Andre-WL/Model_DC_Microgrid/A DC Housing Outreach proejct.pptx

## 2021/2022 FAN Summer Research Scholarship

Name: Andre Webber
Project: DC Housing Community Outreach Project

Notes: NAME:
Hello, my name is Andre. I am an Electrical and Electronics Engineering student at VUW.
PROJECT
Over the summer I have been working on a DC housing outreach project aimed at high school students.

## Project Details

- 4 scale model houses
- Simulation of household power consumption over a 24-hour period.
- Current Sampling

Notes: 4 scale model houses
The idea of this project is to produce 4 scale model houses, each containing “appliances” represented by LEDs and load resistors to dissipate power at a 1:100 scale to the appliances they represent.
Simulation of household power consumption over a 24-hour period.
Appliances must be individually switched to allow for a simulation of household power consumption over a 24-hour period.
Current Sampling
Current will be sampled at each simulation tick so a power vs time graph can be generated

## What I have done

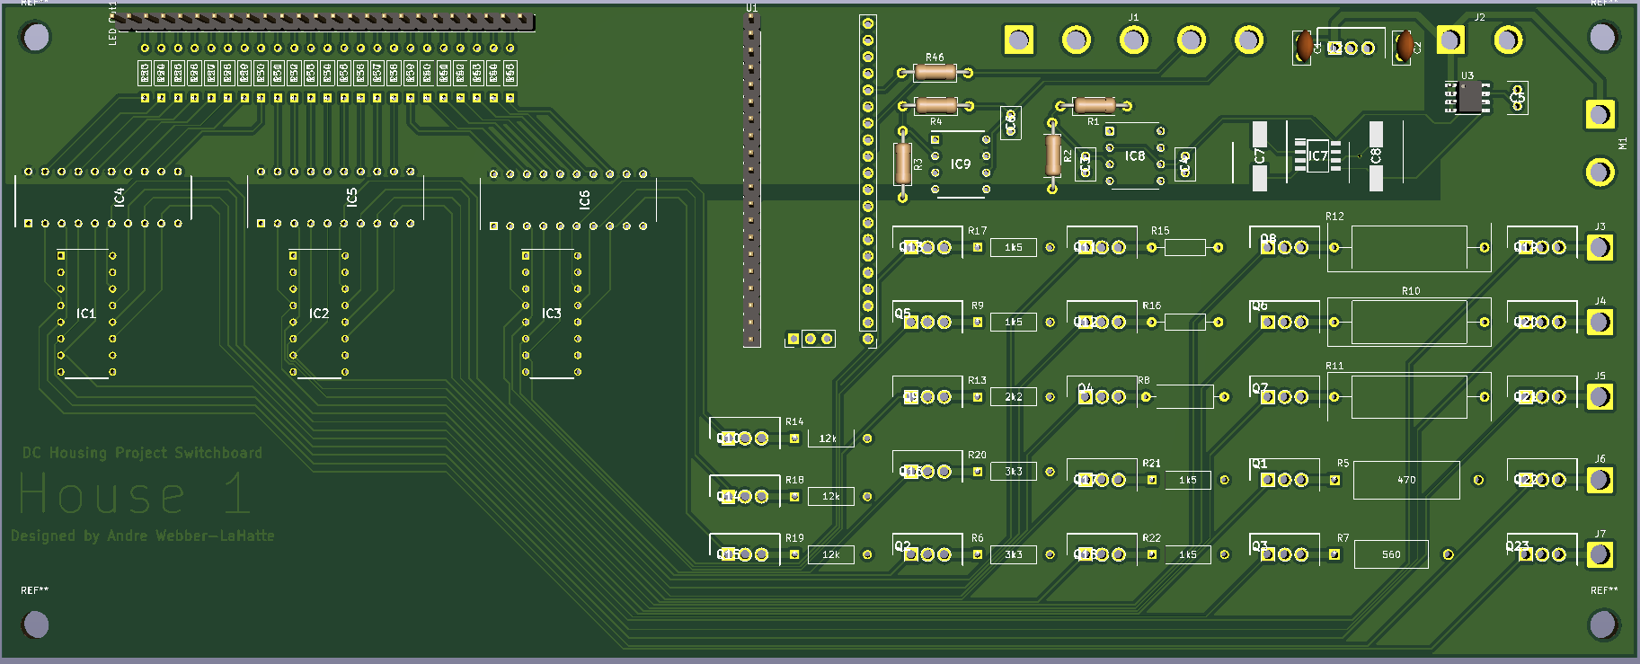
[picture p1: figure]

Switch Board

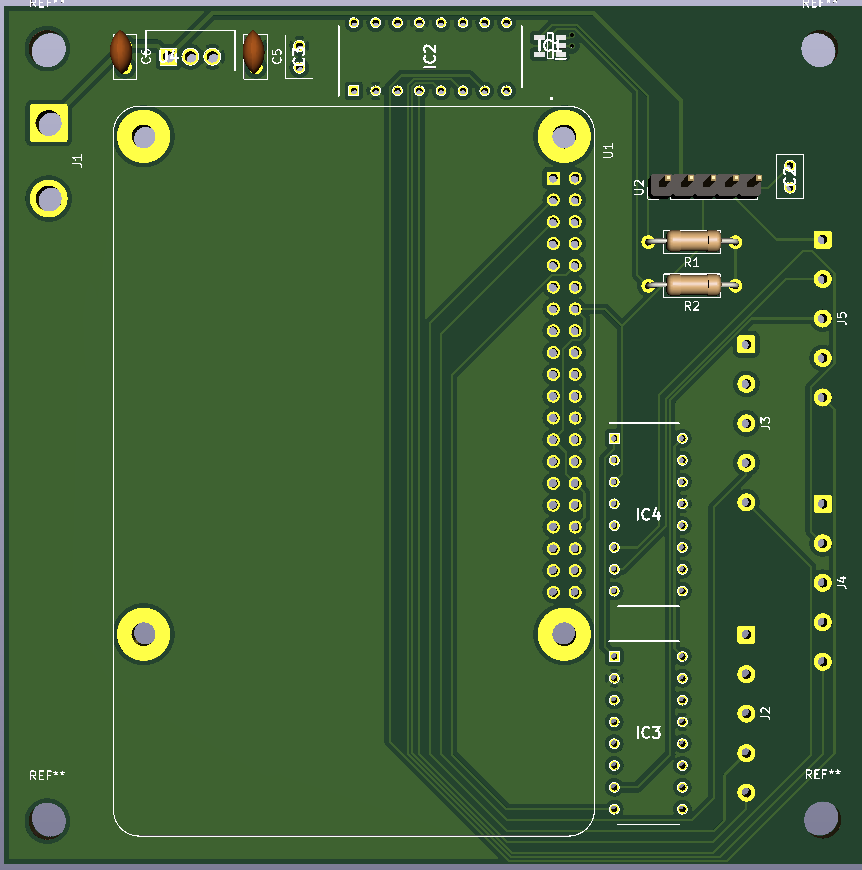
[picture p2: figure]

Control Board

Notes: So far, I have completed designs, and ordered components for 2 PCBs:
Switch Board
Using a Raspberry Pi Pico, this board controls the switching of each appliance, with an output that allows the LEDs within the house models to be connected. This board also houses the load resistors and current detection circuit for each house.
Control Board
Using a Raspberry Pi, this board can communicate and sample current individually from 4 houses

## Design Approach

- Communication
- Switching
- Current Detection

Notes: My design approach focussed on 3 main aspects.
Communication.
Communication.
Switching.
Switching.
Current Detection.
Current detection.

## Communication

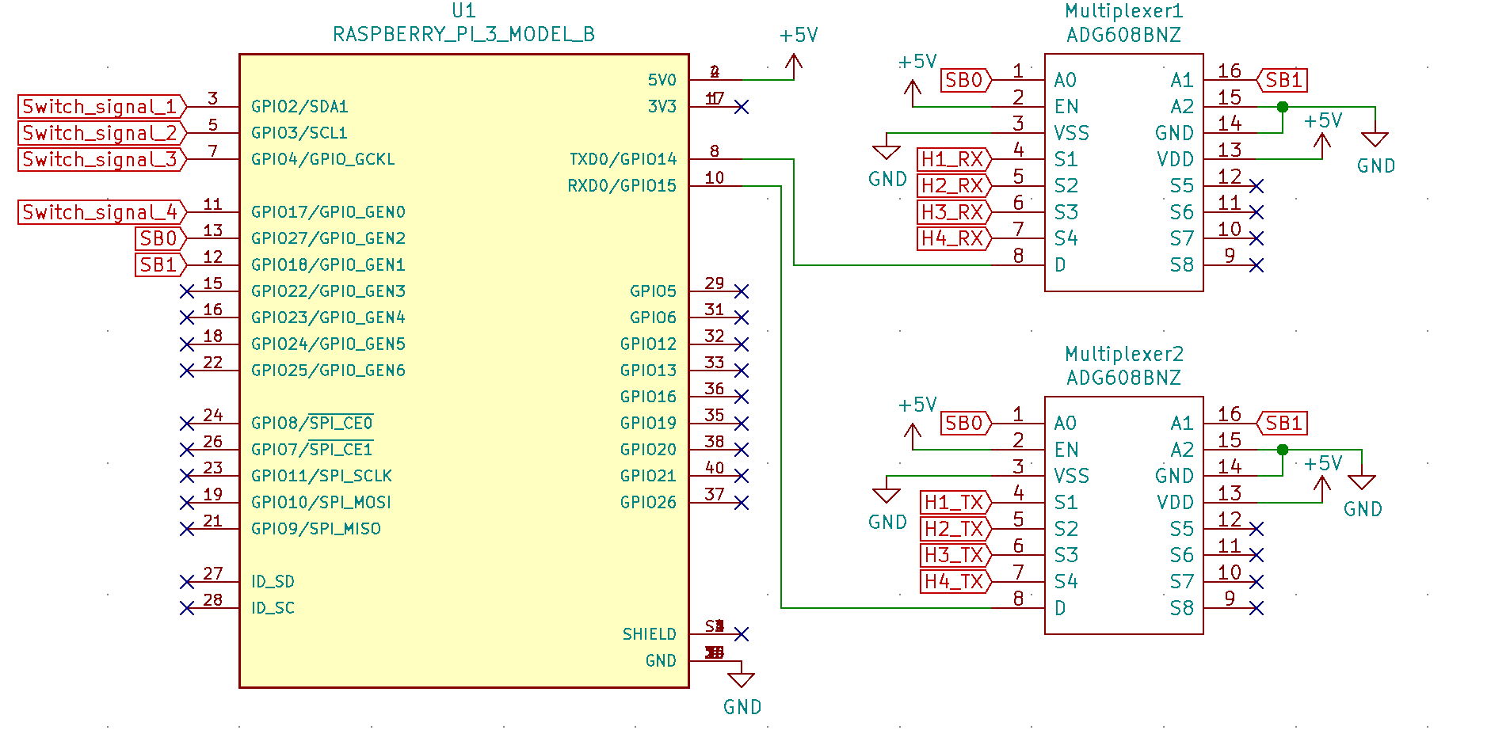
[picture p3: figure]

Control end

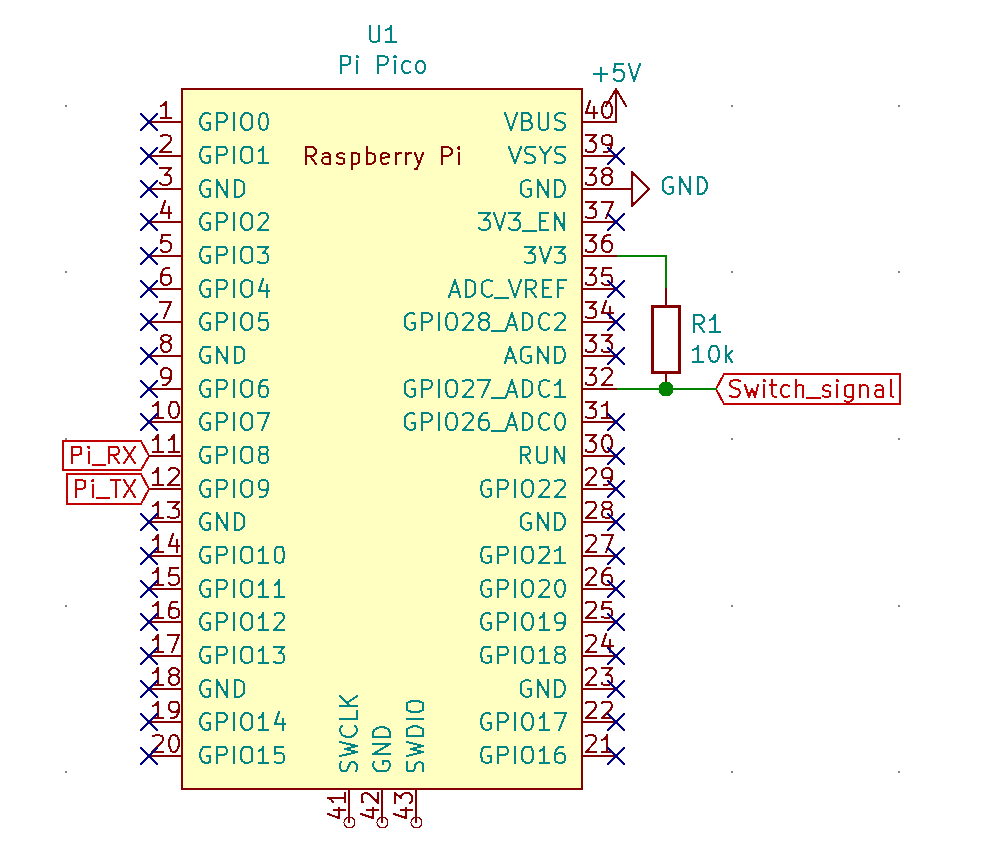
[picture p4: figure]

House end

Notes: Control end:
Using 2 4:1 multiplexers (or in this case, 2 8:1) the Raspberry Pi can communicate individually with each house over UART by selecting which house it is talking/listening to. The Pi also used a single line per house which will be pulled low to indicate a switch needs to be made.
House end:
This is a quick schematic showing the Pico end of communication topology. Showing the pull up resistor on the switch signal line.

## Switching

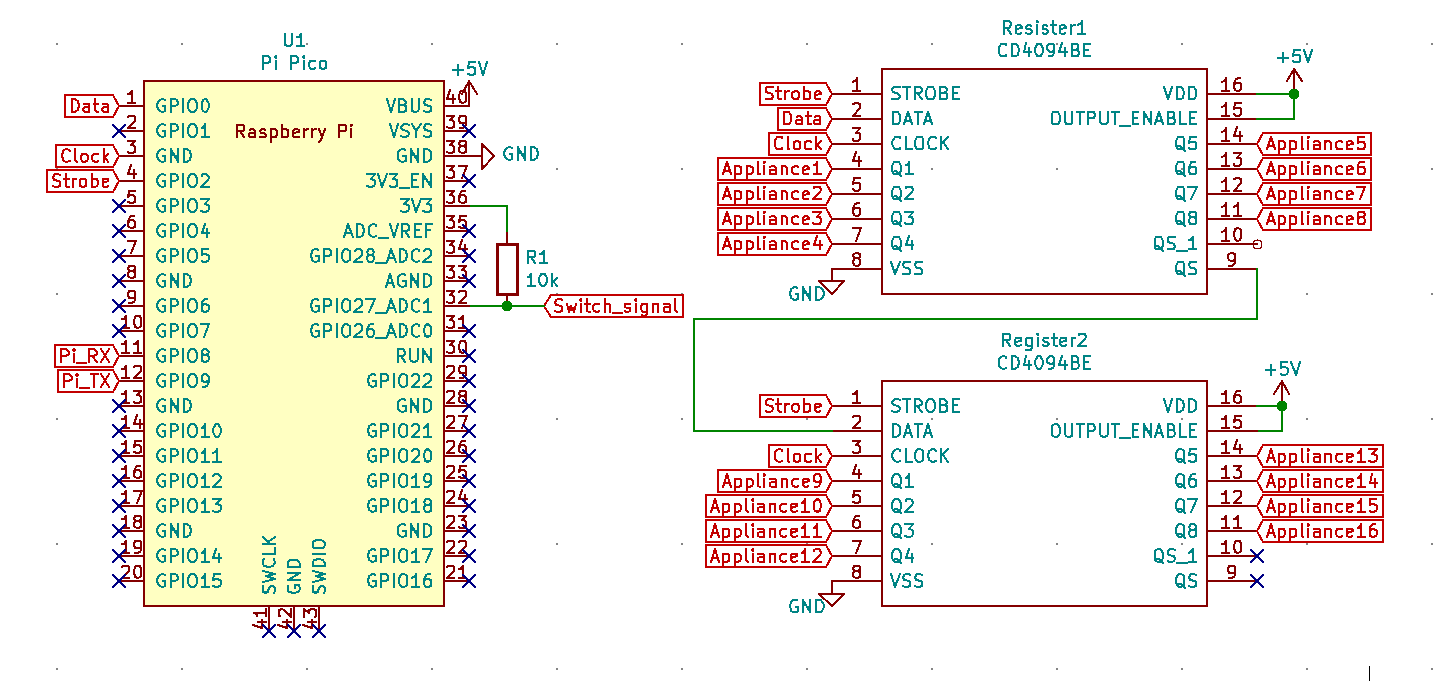
[picture p5: figure]

Shift Registers

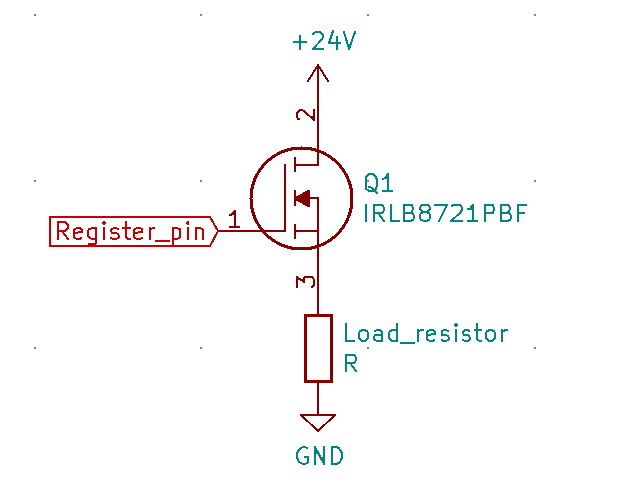
[picture p6: figure]

MOSFET

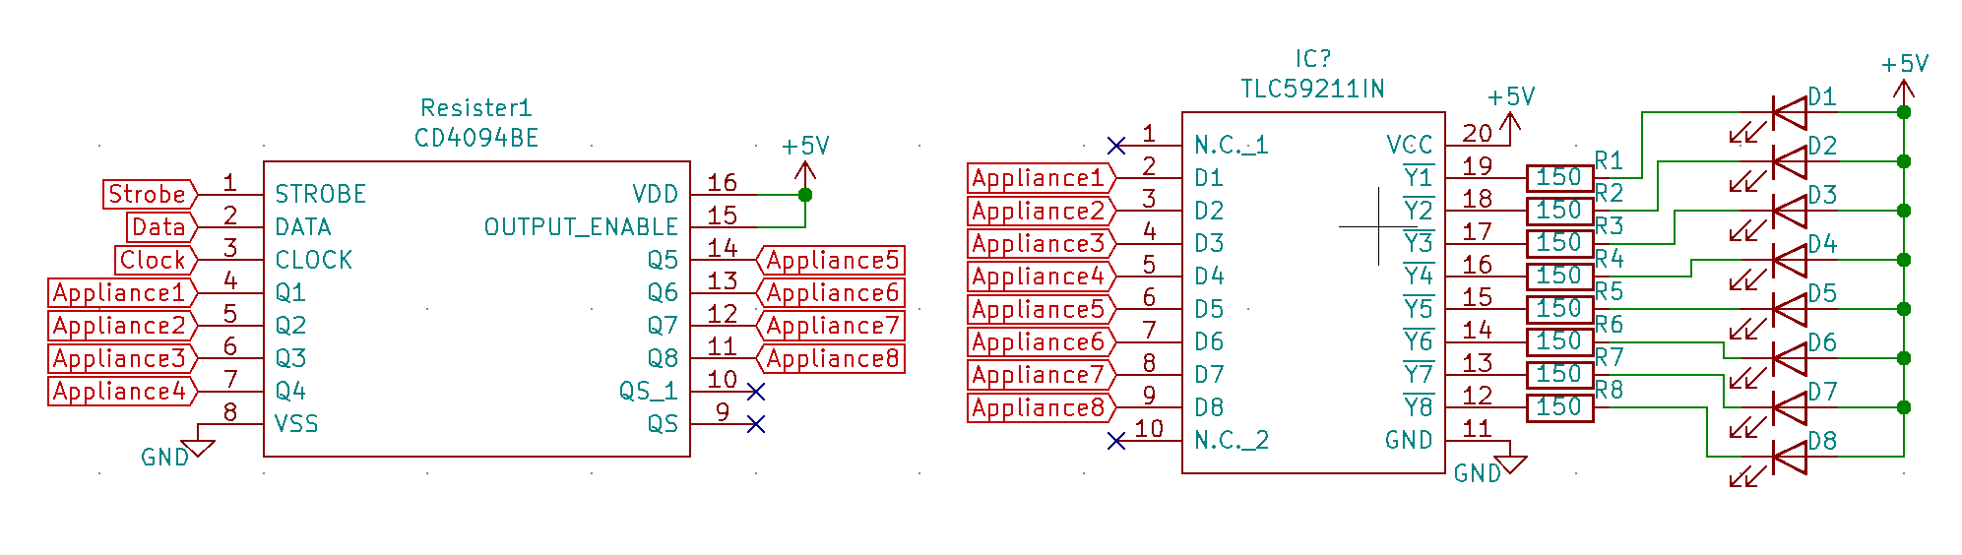
[picture p7: figure]

Sink Driver

Notes: Shift registers
The Pico switches appliances by loading values onto 8-bit shift register, using 1 register for each 8 appliances. They can be serially configured to behave as 16-bit, 24-bit, etc registers. The Pico can serially load values onto an internal register, before “strobing” to the output in parallel. This allows for values to be preloaded before a switch signal is received.
MOSFET
The registers output to MOSFETs to switch load resistors. I chose a MOSFET with a low R_(DS(on)) of 6.5mΩ , and a voltage rating greater than the 24V supply used for the load resistors.
Sink driver
As the registers cannot source enough current to drive LEDs, they also output to sink drivers. The schematic shows the connection made to LEDs, however in reality the LEDs will all be off board within a model house.
Shift registers
The Pico switches appliances by loading values onto 8-bit shift register, using 1 register for each 8 appliances. They can be serially configured to behave as 16-bit, 24-bit, etc registers. The Pico can serially load values onto an internal register, before “strobing” to the output in parallel. This allows for values to be preloaded before a switch signal is received.
MOSFET
The registers output to MOSFETs to switch load resistors. I chose a MOSFET with a low R_DS(on) of 6.5mΩ, and a voltage rating greater than the 24V supply used for the load resistors.
Sink driver
As the registers cannot source enough current to drive LEDs, they also output to sink drivers. The schematic shows the connection made to LEDs, however in reality the LEDs will all be off board within a model house.

## Current Detection

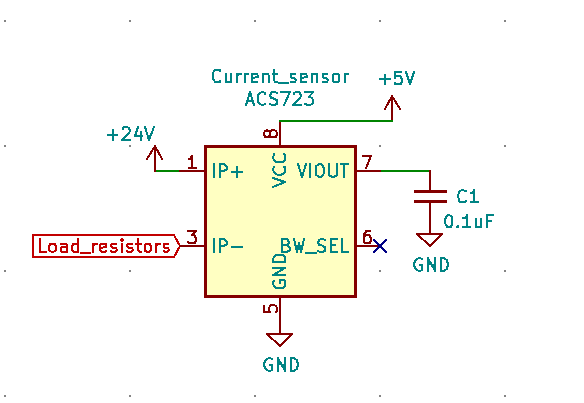
[picture p8: figure]

Sensor

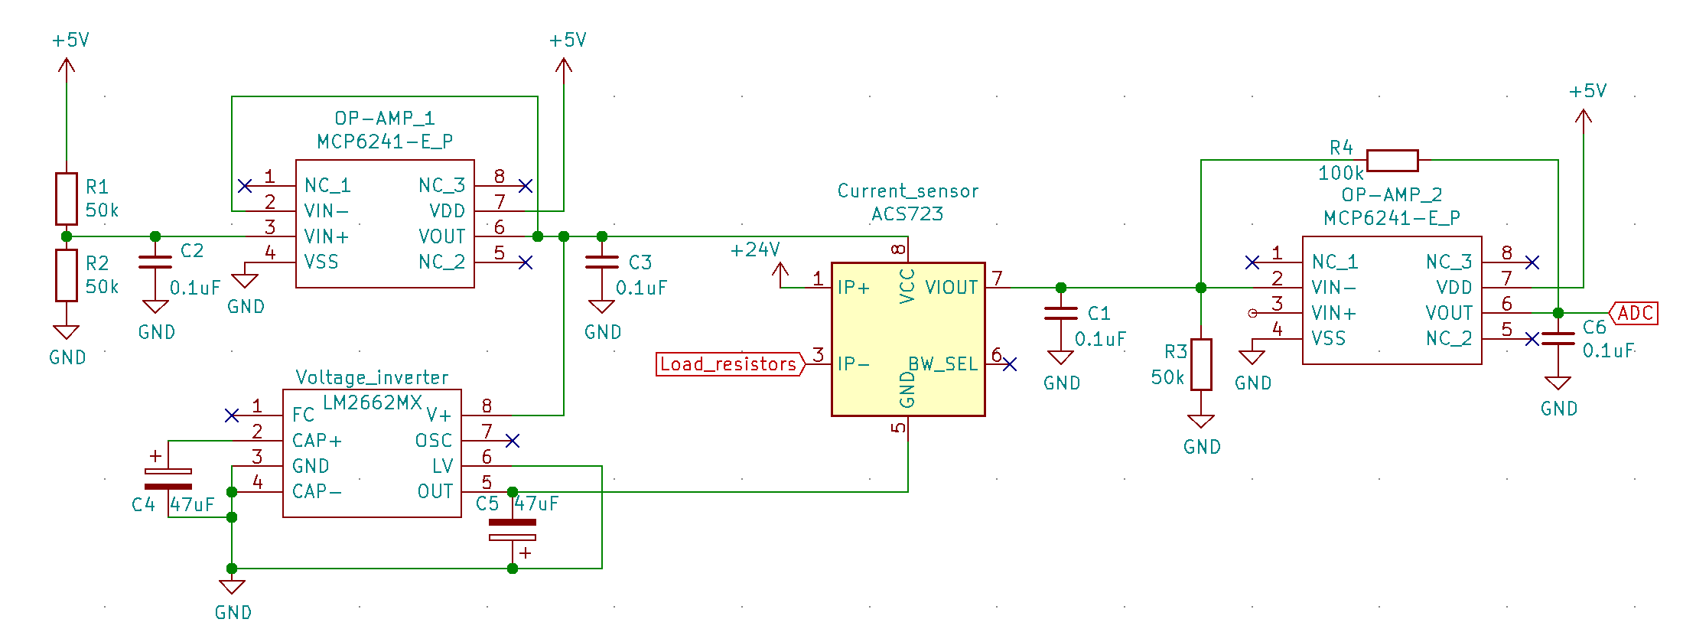
[picture p9: figure]

Inversion and Amplification

Notes: Sensor
The ACS721 is a bi direction current sensor that outputs 400mV/A
Testing
Testing one of these chips showed this output ratio to be accurate. Note the output of 2.5V at 0A due to being bidirectional.

## Current Detection

- Multiplexing
- ADC

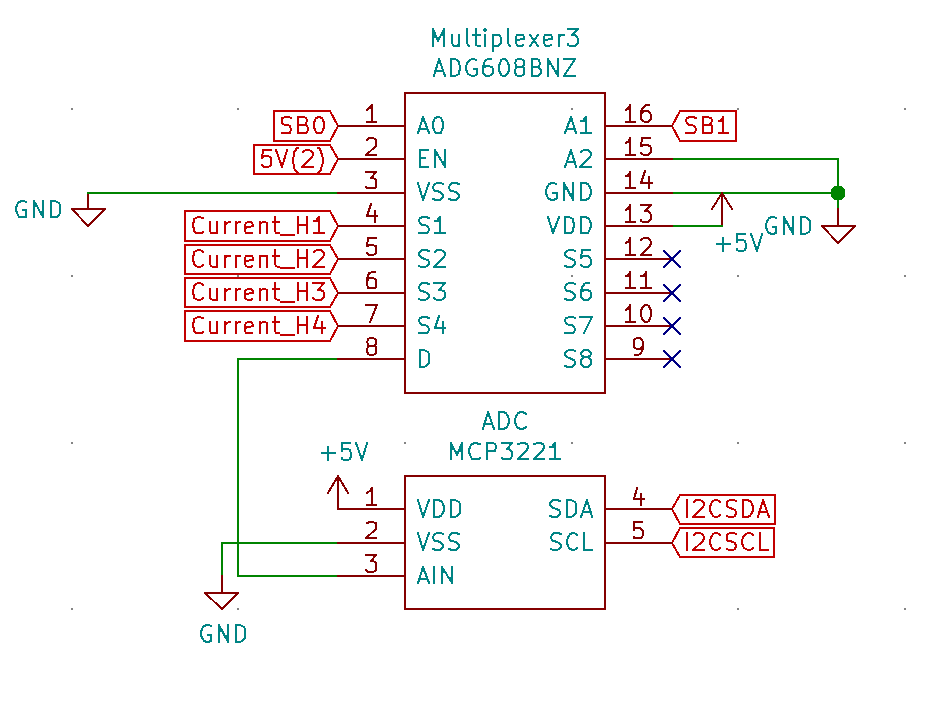
[picture p10: figure]

Notes: Multiplexing
The amplifier outputs to a multiplexer on the control board that then output to an ADC, this way current detection can be done across all 4 houses using a single ADC.
ADC
The MCP3221 ADC has 12-bit resolution, and a 22.3k sample rate.

## Switch Board Full Schematic

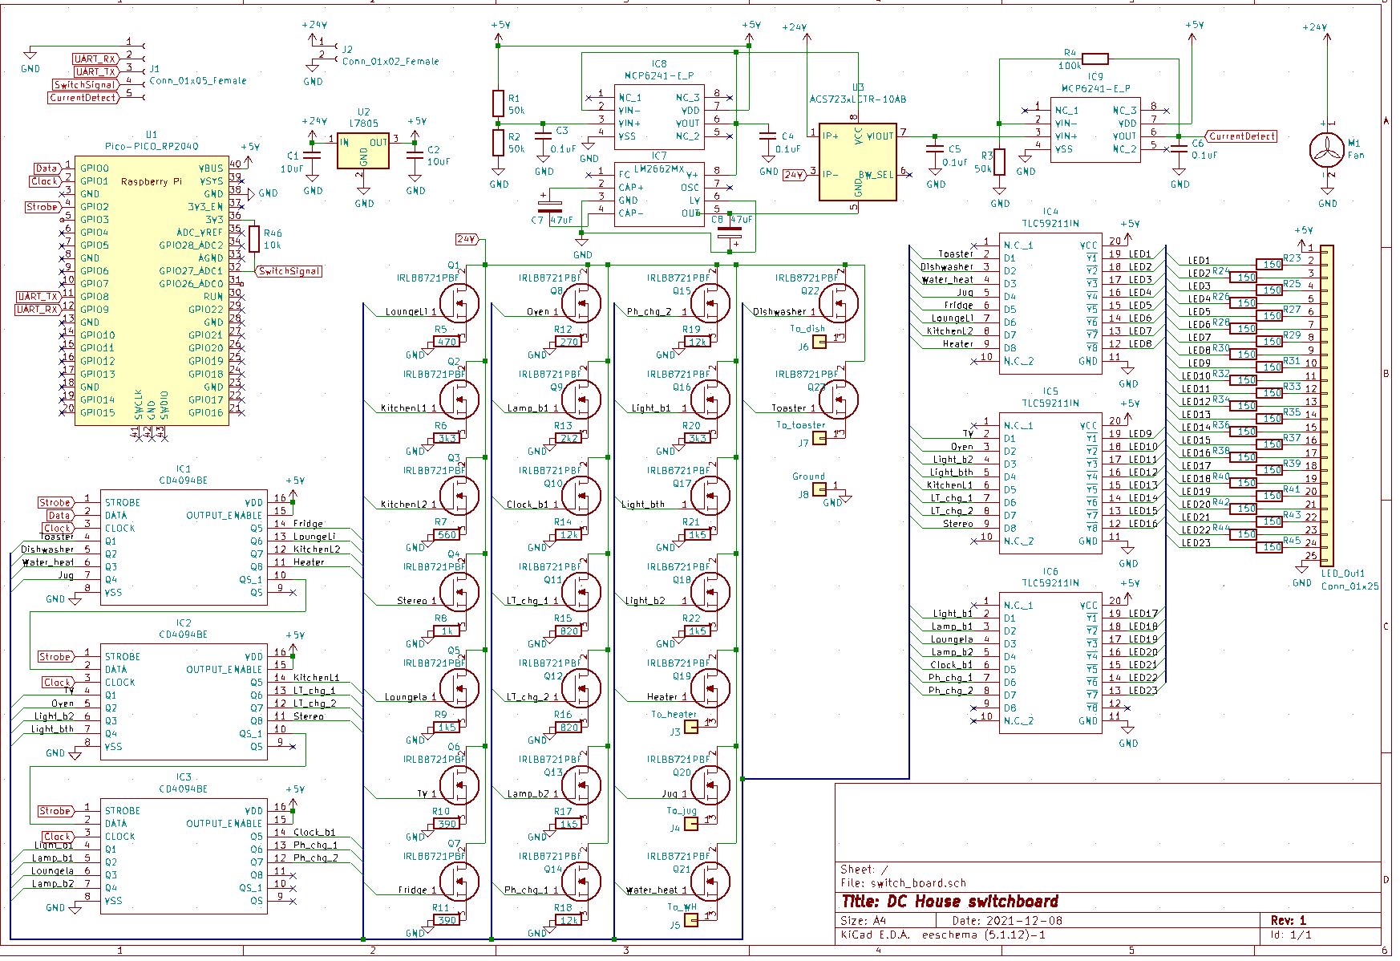
[picture p11: figure]

Notes: Say what it is

## Control Board Full Schematic

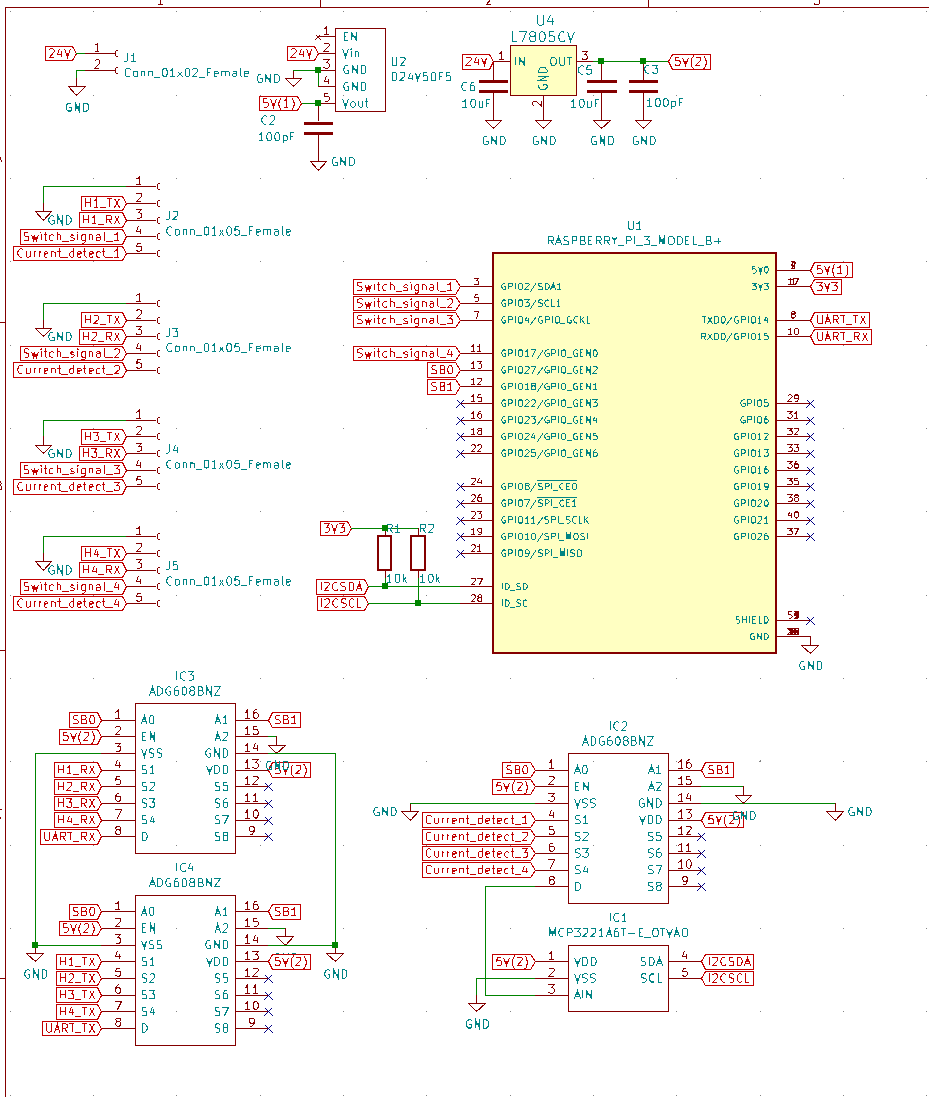
[picture p12: figure]

Notes: Say what it is

## Raspberry Pi Software Process

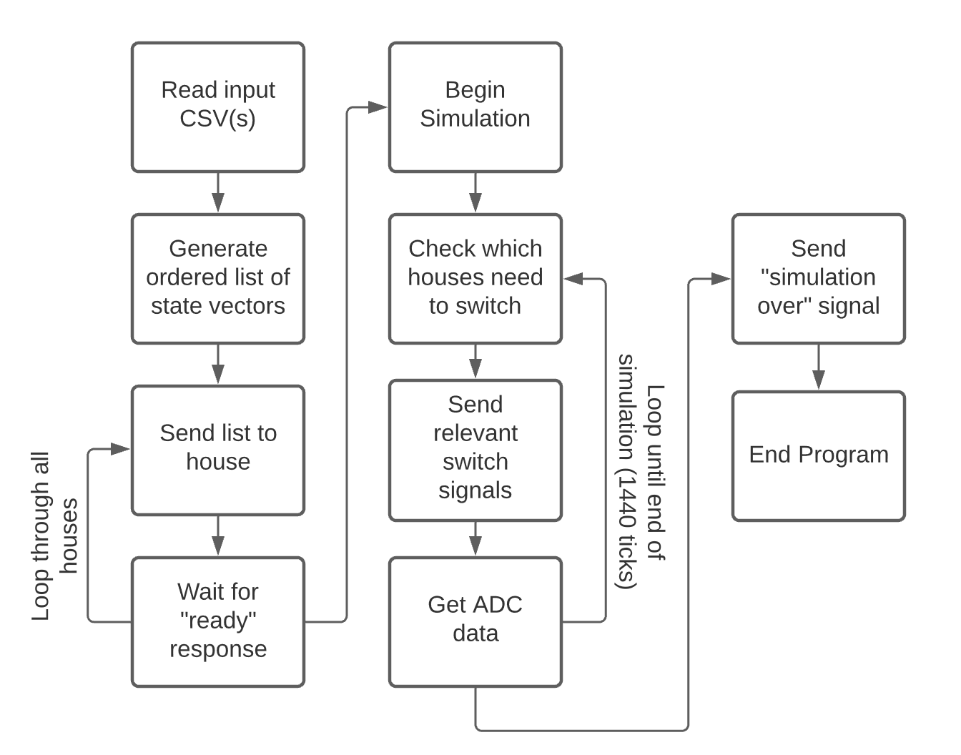
[picture p13: figure]

Notes: Quickly talk through process

## State Vectors

01101111

11101111

AND 01111111

OR 00000010

11101101

Notes: State vectors stored as 1 byte for each appliances
Made by performing logical operations on previous vector
*Click*
To switch this appliance
*Click*
Perform OR
*Click*
TO switch this one
*Click*
Perform AND
*Click*

## Pi Pico Software Process

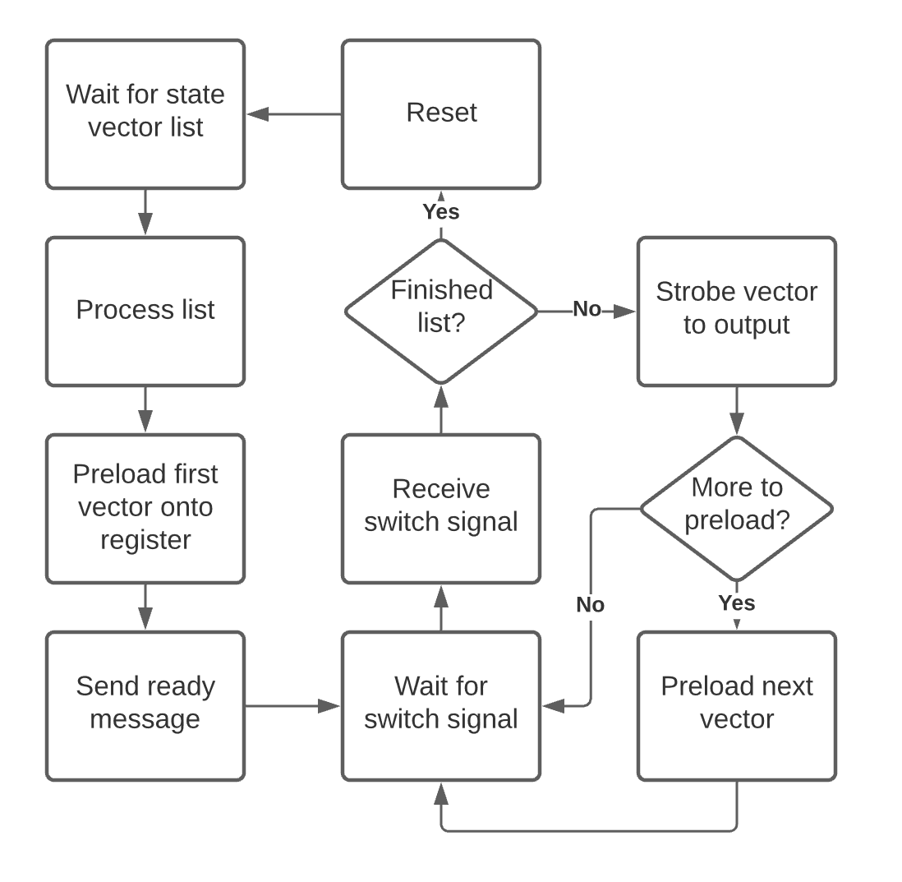
[picture p14: figure]

Notes: Quickly go over process

## What do I still need to do?

Finish Writing Software

01

Design Enclosures for PCBs

02

Make Switchboard PCBs for the other 3 houses

03

Populate PCBs

04

## What Have I Learnt?

- Read Thoroughly
- Component Selection

Notes: Read documentation thoroughly to understand details of what can and can’t be done, and what should be done.
Byte at a time communication
Decide what is needed, design circuit, and select components to make this, change circuit if necessary

## Questions?
