Andre-WL/Model_DC_Microgrid/Circuit_Boards/C320C104J3G5TA/3D/C320C104J3G5TA.stp

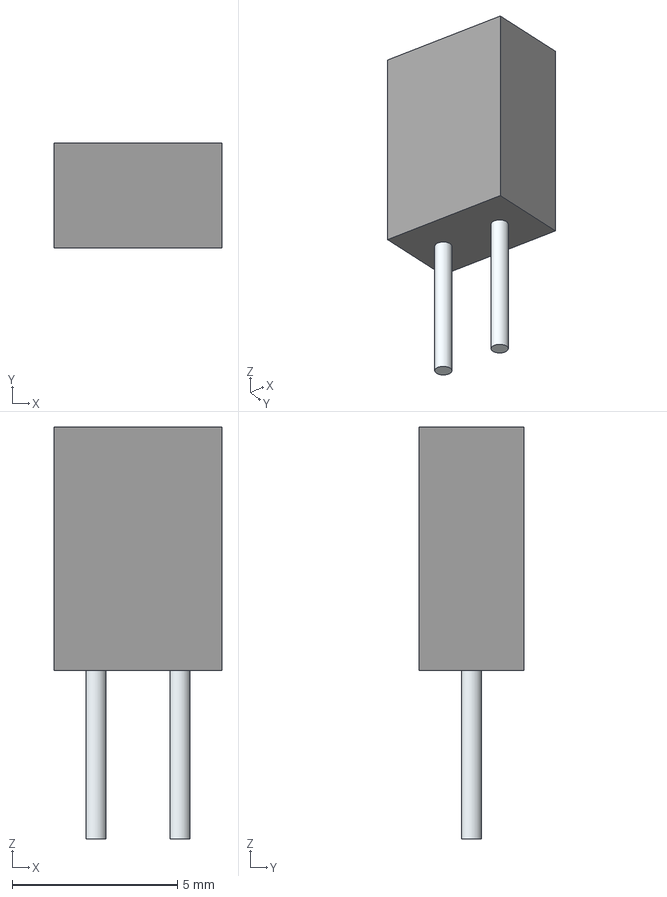
[picture p27: CAD file, 2022-10-04]
Circuit_Boards/C320C104J3G5TA/3D/C320C104J3G5TA.stp
5.08 x 3.18 x 12.5 mm
Leads x 2
