Andre-WL/Model_DC_Microgrid/Circuit_Boards/house_control/ADG608BNZ/3D/ADG608BNZ.stp

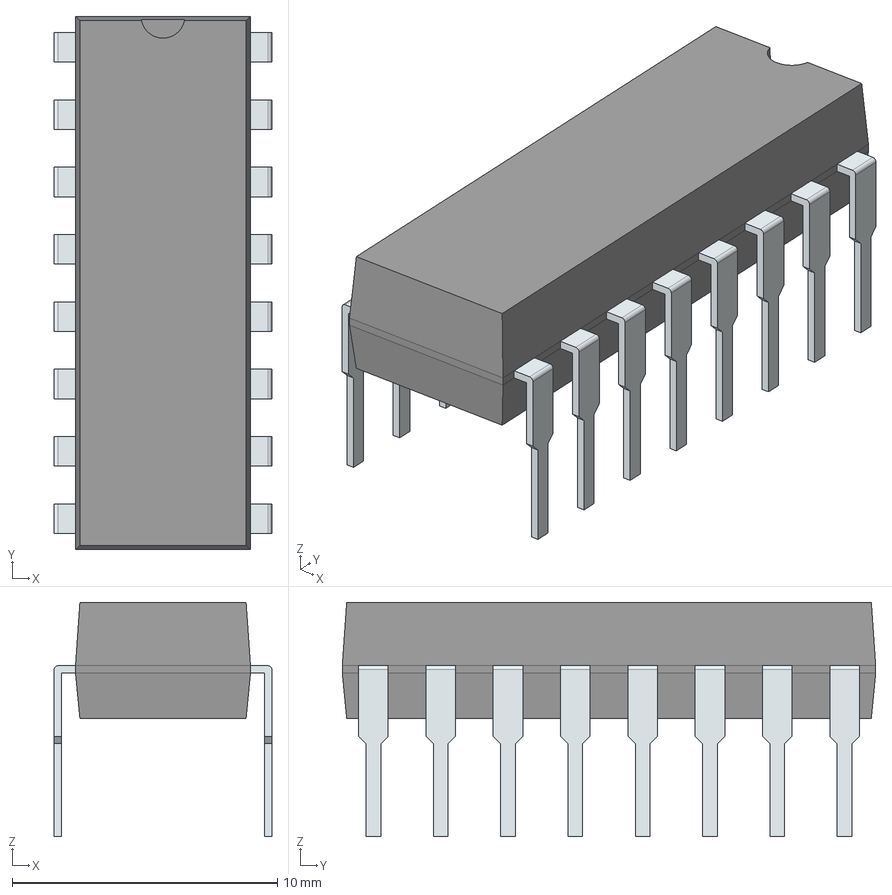
[picture p28: CAD file, 2022-10-04]
Circuit_Boards/house_control/ADG608BNZ/3D/ADG608BNZ.stp
8.21 x 20.1 x 8.83 mm
PinsArrayLR
