Andre-WL/Model_DC_Microgrid/(list of files, cad)

Other CAD files:
Circuit_Boards/C320C104J3G5TA/3D/C320C104J3G5TA.stl
Circuit_Boards/C320C104J3G5TA/Allegro/c320c104j3g5ta.psm
Circuit_Boards/C320C104J3G5TA/DEHDL/c320c104j3g5ta/chips/chips.prt
Circuit_Boards/house_control/ADG608BNZ/3D/ADG608BNZ.stl
Circuit_Boards/house_control/ADG608BNZ/Allegro/dip794w56p254l2013h533q16n.psm
Circuit_Boards/house_control/ADG608BNZ/DEHDL/adg608bnz/chips/chips.prt
