Andre-WL/Model_DC_Microgrid/Circuit_Boards/switch_board_house2/switch_board_house2.kicad_pcb

## KiCad design Circuit_Boards/switch_board_house2/switch_board_house2.kicad_pcb (2022-10-04)

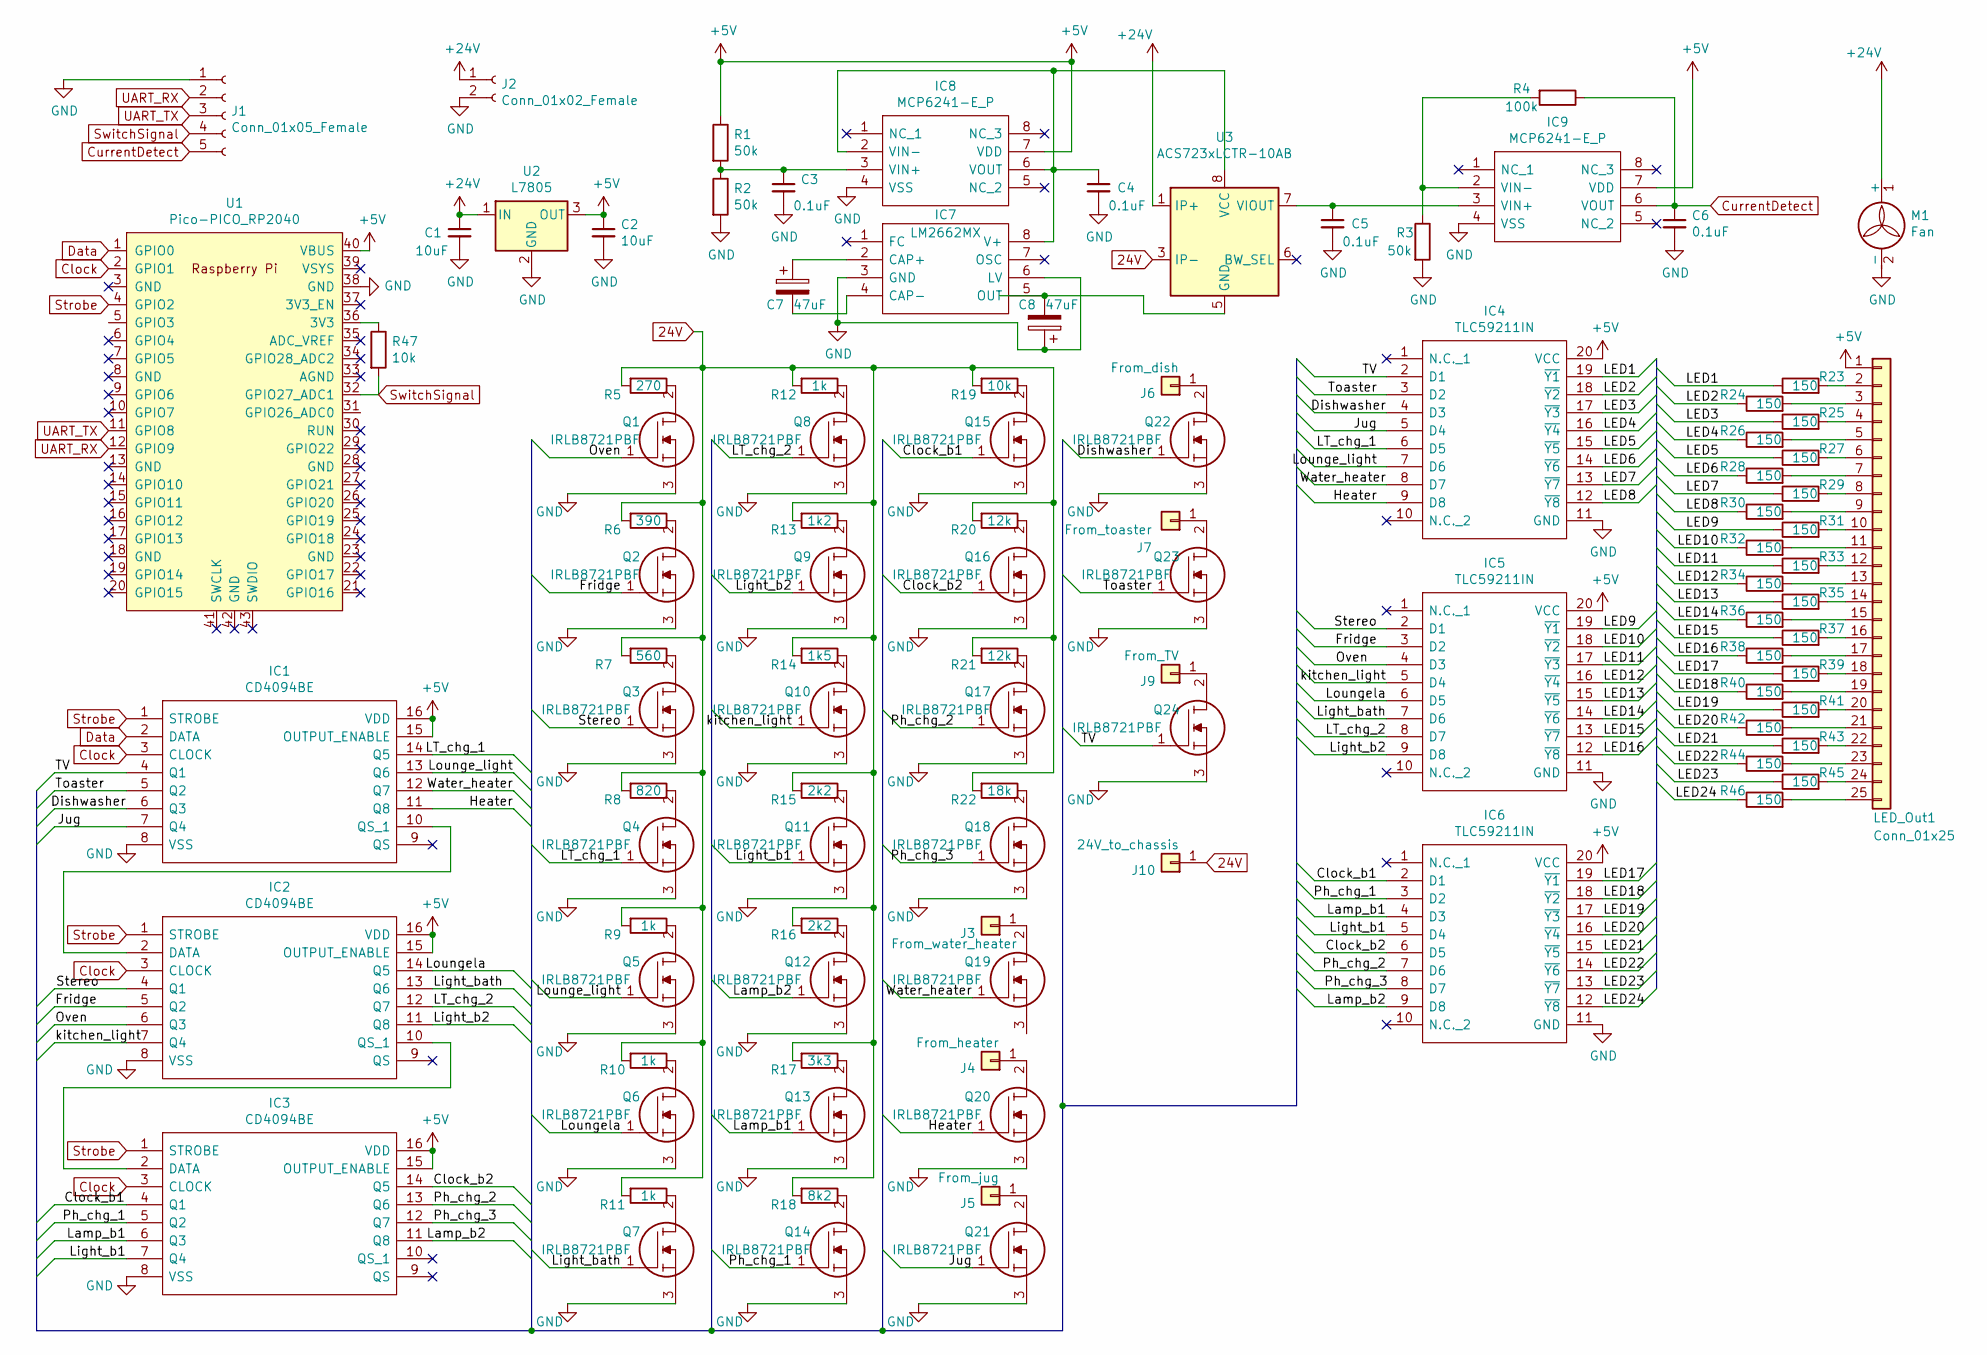
[picture p31: schematic switch_board_house2.sch, DC House switchboard]

Parts:
C1, C2: 10uF; C_Disc_D5.0mm_W2.5mm_P2.50mm
C3, C4, C5, C6: 0.1uF; C320C104J3G5TA
C7, C8: 47uF; CAPAE825X1030N
IC1, IC2, IC3: CD4094BE; DIP794W53P254L1930H508Q16N; Manufacturer_Part_Number CD4094BE; Mouser Part Number 595-CD4094BE
IC4, IC5, IC6: TLC59211IN; DIP794W53P254L2540H508Q20N; Manufacturer_Part_Number TLC59211IN; Mouser Part Number 595-TLC59211IN
IC7: LM2662MX; SOIC127P600X175-8N; Manufacturer_Part_Number LM2662MX; Mouser Part Number 926-LM2662MX
IC8, IC9: MCP6241-E_P; DIP781W56P254L950H533Q8N; Manufacturer_Part_Number MCP6241-E/P; Mouser Part Number 579-MCP6241-E/P
J1: Conn_01x05_Female; SolderWire-2.5sqmm_1x05_P8.8mm_D2.4mm_OD4.4mm
J2: Conn_01x02_Female; SolderWire-2.5sqmm_1x02_P8.8mm_D2.4mm_OD4.4mm
J3: From_water_heater; SolderWire-2.5sqmm_1x01_D2.4mm_OD3.6mm
J4: From_heater; SolderWire-2.5sqmm_1x01_D2.4mm_OD3.6mm
J5: From_jug; SolderWire-2.5sqmm_1x01_D2.4mm_OD3.6mm
J6: From_dish; SolderWire-2.5sqmm_1x01_D2.4mm_OD3.6mm
J7: From_toaster; SolderWire-2.5sqmm_1x01_D2.4mm_OD3.6mm
J9: From_TV; SolderWire-2.5sqmm_1x01_D2.4mm_OD3.6mm
J10: 24V_to_chassis; SolderWire-2.5sqmm_1x01_D2.4mm_OD3.6mm
LED_Out1: Conn_01x25; PinHeader_1x25_P2.54mm_Vertical
M1: Fan; SolderWire-2.5sqmm_1x02_P8.8mm_D2.4mm_OD4.4mm
Q1, Q2, Q3, Q4, Q5, Q6, Q7, Q8, Q9, Q10, Q11, Q12, Q13, Q14, Q15, Q16, Q17, Q18, Q19, Q20, Q21, Q22, Q23, Q24: IRLB8721PBF; TO254P483X1016X1994-3P; Manufacturer_Part_Number IRLB8721PBF; Mouser Part Number 942-IRLB8721PBF
R1, R2, R3: 50k; R_Axial_DIN0207_L6.3mm_D2.5mm_P10.16mm_Horizontal
R4: 100k; R_Axial_DIN0207_L6.3mm_D2.5mm_P10.16mm_Horizontal
R5: 270; ROX5SS
R6: 390; ROX5SS
R7: 560; ROX2SJ560R
R8: 820; MFP1_res
R9, R10, R11, R12: 1k; 1K_load
R13: 1k2; 1k2_res_v2
R14: 1k5; LR1F1K5
R15, R16: 2k2; LR1F1K5
R17: 3k3; LR1F3K3
R18: 8k2; LR1F1K5
R19: 10k; 10k_res
R20, R21: 12k; LR1F1K5
R22: 18k; 18k_res
R23, R24, R25, R26, R27, R28, R29, R30, R31, R32, R33, R34, R35, R36, R37, R38, R39, R40, R41, R42, R43, R44, R45, R46: 150; RNMF14FTC150R
R47: 10k; R_Axial_DIN0207_L6.3mm_D2.5mm_P10.16mm_Horizontal
U1: Pico-PICO_RP2040; PinHeader_2x20_P2.54mm_PICO
U2: L7805; TO255P460X1020X2008-3P
U3: ACS723xLCTR-10AB; SOIC-8_3.9x4.9mm_P1.27mm

Connections:
24V: J10.1, R5.2, R6.2, R7.2, R8.2, R9.2, R10.2, R11.2, R12.2, R13.2, R14.2, R15.2, R16.2, R17.2, R18.2, R19.2, R20.2, R21.2, R22.2, U3.3 (IP-), U3.4 (IP-)
+5V: C2.1, IC1.15 (OUTPUT_ENABLE), IC1.16 (VDD), IC2.15 (OUTPUT_ENABLE), IC2.16 (VDD), IC3.15 (OUTPUT_ENABLE), IC3.16 (VDD), IC4.20 (VCC), IC5.20 (VCC), IC6.20 (VCC), IC8.7 (VDD), IC9.7 (VDD), LED_Out1.1, R1.1, U1.40 (VBUS), U2.3 (OUT)
+24V: C1.1, J2.1, M1.1 (+), U2.1 (IN), U3.1 (IP+), U3.2 (IP+)
/Clock_b1: IC3.4 (Q1), IC6.2 (D1), Q15.1
/Clock_b2: IC3.14 (Q5), IC6.6 (D5), Q16.1
/Dishwasher: IC1.6 (Q3), IC4.4 (D3), Q22.1
/Fridge: IC2.5 (Q2), IC5.3 (D2), Q2.1
/Heater: IC1.11 (Q8), IC4.9 (D8), Q20.1
/Jug: IC1.7 (Q4), IC4.5 (D4), Q21.1
/LED1: IC4.19 (~Y1), R23.1
/LED2: IC4.18 (~Y2), R24.1
/LED3: IC4.17 (~Y3), R25.1
/LED4: IC4.16 (~Y4), R26.1
/LED5: IC4.15 (~Y5), R27.1
/LED6: IC4.14 (~Y6), R28.1
/LED7: IC4.13 (~Y7), R29.1
/LED8: IC4.12 (~Y8), R30.1
/LED9: IC5.19 (~Y1), R31.1
/LED10: IC5.18 (~Y2), R32.1
/LED11: IC5.17 (~Y3), R33.1
/LED12: IC5.16 (~Y4), R34.1
/LED13: IC5.15 (~Y5), R35.1
/LED14: IC5.14 (~Y6), R36.1
/LED15: IC5.13 (~Y7), R37.1
/LED16: IC5.12 (~Y8), R38.1
/LED17: IC6.19 (~Y1), R39.1
/LED18: IC6.18 (~Y2), R40.1
/LED19: IC6.17 (~Y3), R41.1
/LED20: IC6.16 (~Y4), R42.1
/LED21: IC6.15 (~Y5), R43.1
/LED22: IC6.14 (~Y6), R44.1
/LED23: IC6.13 (~Y7), R45.1
/LED24: IC6.12 (~Y8), R46.1
/LT_chg_1: IC1.14 (Q5), IC4.6 (D5), Q4.1
/LT_chg_2: IC2.12 (Q7), IC5.8 (D7), Q8.1
/Lamp_b1: IC3.6 (Q3), IC6.4 (D3), Q13.1
/Lamp_b2: IC3.11 (Q8), IC6.9 (D8), Q12.1
/Light_b1: IC3.7 (Q4), IC6.5 (D4), Q11.1
/Light_b2: IC2.11 (Q8), IC5.9 (D8), Q9.1
/Light_bath: IC2.13 (Q6), IC5.7 (D6), Q7.1
/Lounge_light: IC1.13 (Q6), IC4.7 (D6), Q5.1
/Loungela: IC2.14 (Q5), IC5.6 (D5), Q6.1
/Oven: IC2.6 (Q3), IC5.4 (D3), Q1.1
/Ph_chg_1: IC3.5 (Q2), IC6.3 (D2), Q14.1
/Ph_chg_2: IC3.13 (Q6), IC6.7 (D6), Q17.1
/Ph_chg_3: IC3.12 (Q7), IC6.8 (D7), Q18.1
/Stereo: IC2.4 (Q1), IC5.2 (D1), Q3.1
/TV: IC1.4 (Q1), IC4.2 (D1), Q24.1
/Toaster: IC1.5 (Q2), IC4.3 (D2), Q23.1
/Water_heater: IC1.12 (Q7), IC4.8 (D7), Q19.1
/kitchen_light: IC2.7 (Q4), IC5.5 (D4), Q10.1
Clock: IC1.3 (CLOCK), IC2.3 (CLOCK), IC3.3 (CLOCK), U1.2 (GPIO1)
CurrentDetect: C6.1, IC9.6 (VOUT), J1.5, R4.1
Data: IC1.2 (DATA), U1.1 (GPIO0)
GND: C1.2, C2.2, C3.2, C4.2, C5.2, C6.2, C8.1, IC1.8 (VSS), IC2.8 (VSS), IC3.8 (VSS), IC4.11 (GND), IC5.11 (GND), IC6.11 (GND), IC7.3 (GND), IC7.6 (LV), IC8.4 (VSS), IC9.4 (VSS), J1.1, J2.2, M1.2 (-), Q1.3, Q2.3, Q3.3, Q4.3, Q5.3, Q6.3, Q7.3, Q8.3, Q9.3, Q10.3, Q11.3, Q12.3, Q13.3, Q14.3, Q15.3, Q16.3, Q17.3, Q18.3, Q20.3, Q21.3, Q22.3, Q23.3, Q24.3, R2.2, R3.2, U1.38 (GND), U2.2 (GND)
unnamed: C3.1, IC8.3 (VIN+), R1.2, R2.1
unnamed: C4.1, IC7.8 (V+), IC8.2 (VIN-), IC8.6 (VOUT), U3.8 (VCC)
unnamed: C5.1, IC9.3 (VIN+), U3.7 (VIOUT)
unnamed: C7.1, IC7.2 (CAP+)
unnamed: C7.2, IC7.4 (CAP-)
unnamed: C8.2, IC7.5 (OUT), U3.5 (GND)
unnamed: IC1.10 (QS_1), IC2.2 (DATA)
unnamed: IC2.10 (QS_1), IC3.2 (DATA)
unnamed: IC9.2 (VIN-), R3.1, R4.2
unnamed: J3.1, Q19.2
unnamed: J4.1, Q20.2
unnamed: J5.1, Q21.2
unnamed: J6.1, Q22.2
unnamed: J7.1, Q23.2
unnamed: J9.1, Q24.2
unnamed: LED_Out1.2, R23.2
unnamed: LED_Out1.3, R24.2
unnamed: LED_Out1.4, R25.2
unnamed: LED_Out1.5, R26.2
unnamed: LED_Out1.6, R27.2
unnamed: LED_Out1.7, R28.2
unnamed: LED_Out1.8, R29.2
unnamed: LED_Out1.9, R30.2
unnamed: LED_Out1.10, R31.2
unnamed: LED_Out1.11, R32.2
unnamed: LED_Out1.12, R33.2
unnamed: LED_Out1.13, R34.2
unnamed: LED_Out1.14, R35.2
unnamed: LED_Out1.15, R36.2
unnamed: LED_Out1.16, R37.2
unnamed: LED_Out1.17, R38.2
unnamed: LED_Out1.18, R39.2
unnamed: LED_Out1.19, R40.2
unnamed: LED_Out1.20, R41.2
unnamed: LED_Out1.21, R42.2
unnamed: LED_Out1.22, R43.2
unnamed: LED_Out1.23, R44.2
unnamed: LED_Out1.24, R45.2
unnamed: LED_Out1.25, R46.2
unnamed: Q1.2, R5.1
unnamed: Q2.2, R6.1
unnamed: Q3.2, R7.1
unnamed: Q4.2, R8.1
unnamed: Q5.2, R9.1
unnamed: Q6.2, R10.1
unnamed: Q7.2, R11.1
unnamed: Q8.2, R12.1
unnamed: Q9.2, R13.1
unnamed: Q10.2, R14.1
unnamed: Q11.2, R15.1
unnamed: Q12.2, R16.1
unnamed: Q13.2, R17.1
unnamed: Q14.2, R18.1
unnamed: Q15.2, R19.1
unnamed: Q16.2, R20.1
unnamed: Q17.2, R21.1
unnamed: Q18.2, R22.1
unnamed: R47.1, U1.36 (3V3)
Strobe: IC1.1 (STROBE), IC2.1 (STROBE), IC3.1 (STROBE), U1.4 (GPIO2)
SwitchSignal: J1.4, R47.2, U1.32 (GPIO27_ADC1)
UART_RX: J1.2, U1.12 (GPIO9)
UART_TX: J1.3, U1.11 (GPIO8)

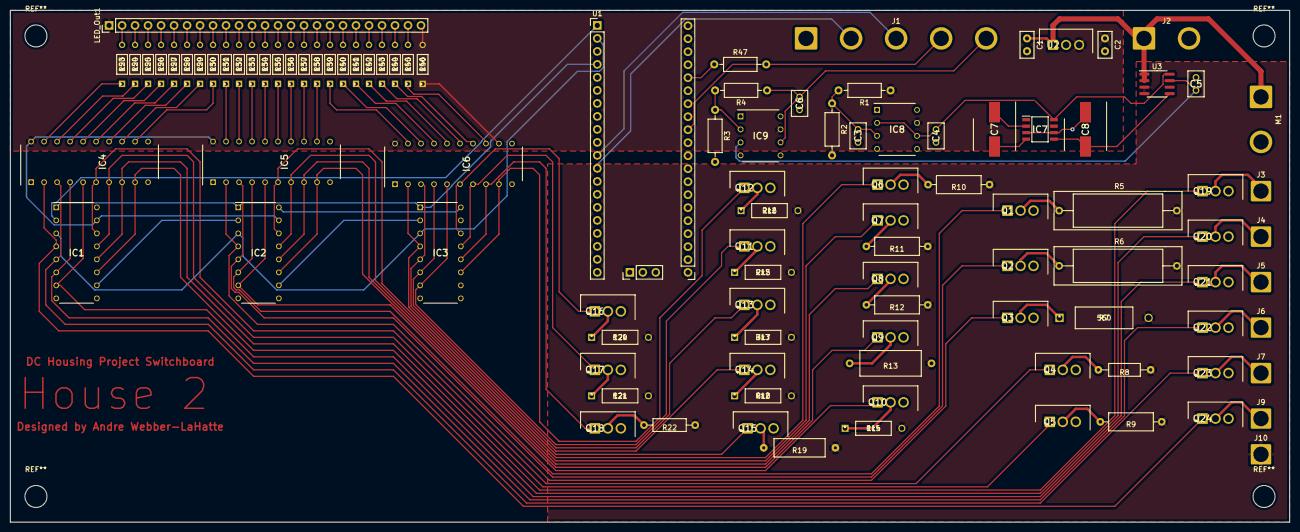
[picture p32: board switch_board_house2.kicad_pcb from above]

Board: 2 copper layers, 250.0 x 100.0 mm, 102 parts (0 on the bottom side), 117 nets.
