Andre-WL/Model_DC_Microgrid/Circuit_Boards/house_control/HouseController.kicad_pcb

## KiCad design Circuit_Boards/house_control/HouseController.kicad_pcb (2022-10-04)

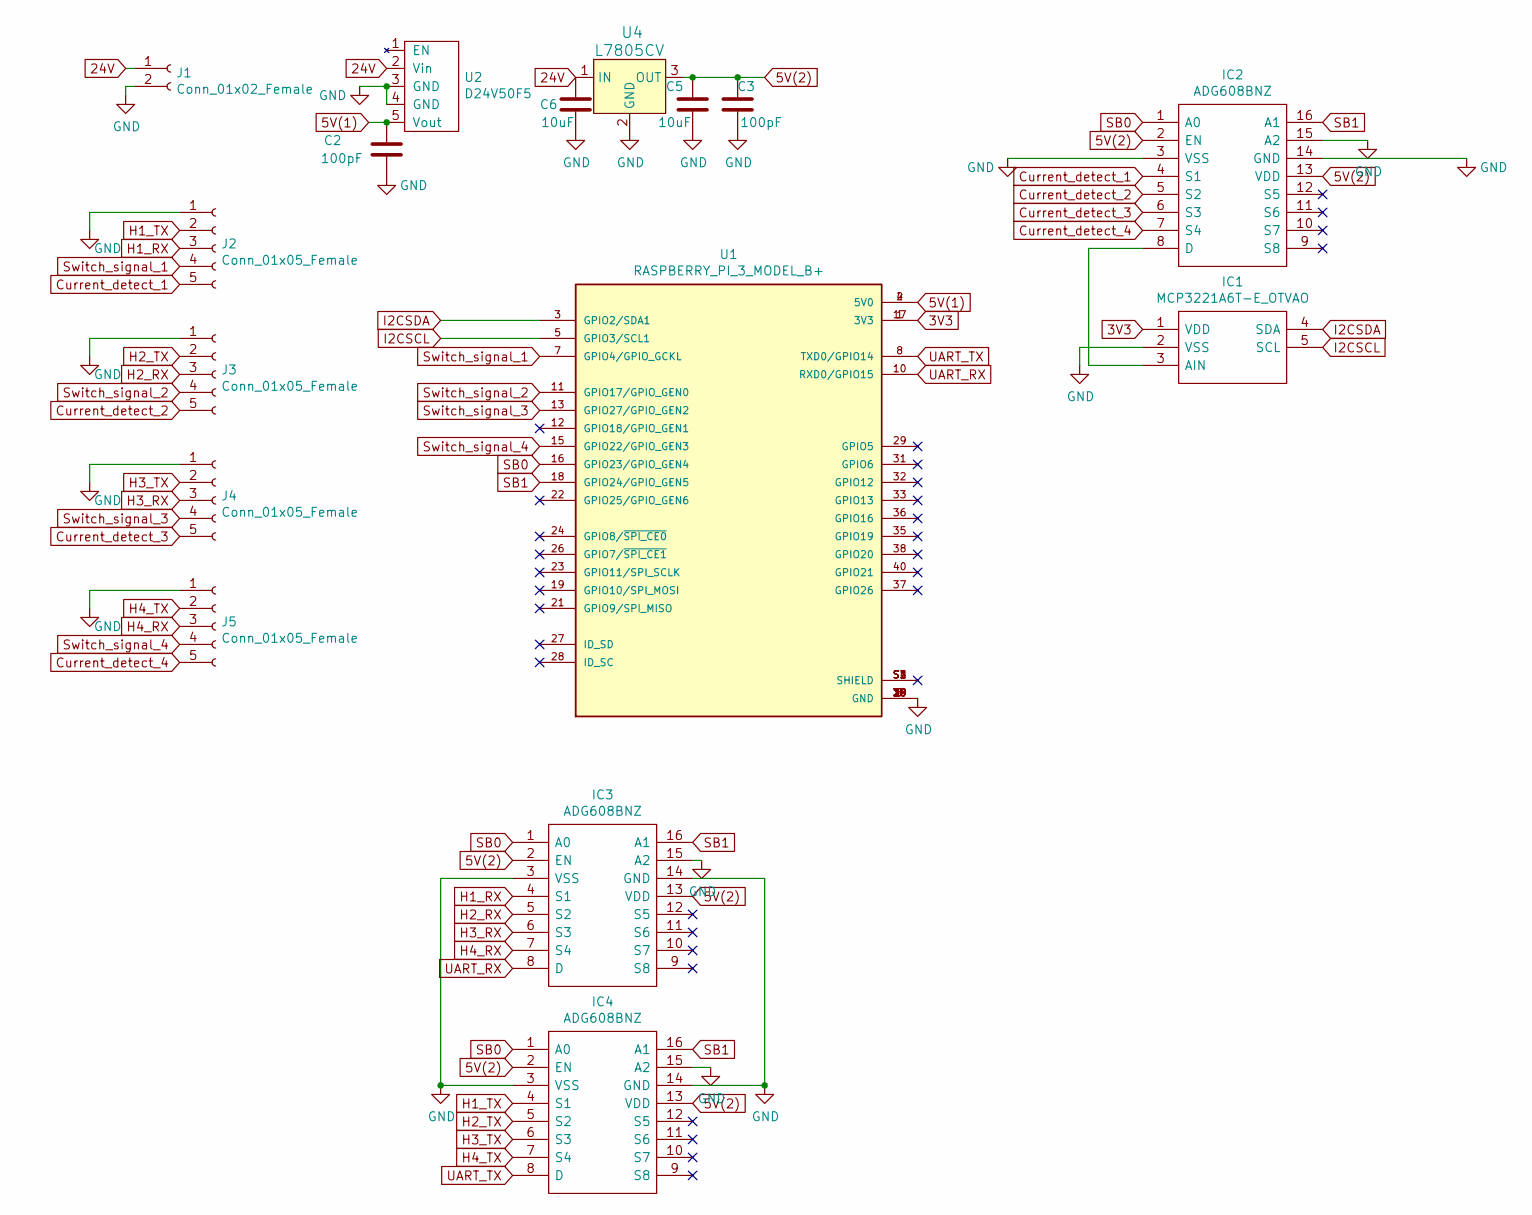
[picture p33: schematic HouseController.sch]

Parts:
C2, C3: 100pF; C320C104J3G5TA
C5, C6: 10uF; C_Disc_D5.0mm_W2.5mm_P2.50mm
IC1: MCP3221A6T-E_OTVAO; SOT95P280X145-5N; Manufacturer_Part_Number MCP3221A6T-E/OTVAO; Mouser Part Number 579-MCP3221A6TEOTVAO
IC2, IC3, IC4: ADG608BNZ; DIP794W56P254L2013H533Q16N; Manufacturer_Part_Number ADG608BNZ; Mouser Part Number 584-ADG608BNZ
J1: Conn_01x02_Female; SolderWire-2.5sqmm_1x02_P8.8mm_D2.4mm_OD4.4mm
J2, J3, J4, J5: Conn_01x05_Female; SolderWire-0.5sqmm_1x05_P4.6mm_D0.9mm_OD2.1mm
U1: RASPBERRY_PI_3_MODEL_B+; MODULE_RASPBERRY_PI_3_MODEL_B+; PARTREV 1.0
U2: D24V50F5; PinHeader_1x05_P2.54mm_Vertical
U4: L7805CV; TO255P460X1020X2008-3P; MPN L7805CV; Digi-Key_PN 497-1443-5-ND

Connections:
3V3: IC1.1 (VDD), U1.1 (3V3), U1.17 (3V3)
5V(1): C2.1, U1.2 (5V0), U1.4 (5V0), U2.5 (Vout)
5V(2): C3.2, C5.1, IC2.2 (EN), IC2.13 (VDD), IC3.2 (EN), IC3.13 (VDD), IC4.2 (EN), IC4.13 (VDD), U4.3 (OUT)
24V: C6.1, J1.1, U2.2 (Vin), U4.1 (IN)
Current_detect_1: IC2.4 (S1), J2.5
Current_detect_2: IC2.5 (S2), J3.5
Current_detect_3: IC2.6 (S3), J4.5
Current_detect_4: IC2.7 (S4), J5.5
GND: C2.2, C3.1, C5.2, C6.2, IC1.2 (VSS), IC2.3 (VSS), IC2.14 (GND), IC2.15 (A2), IC3.3 (VSS), IC3.14 (GND), IC3.15 (A2), IC4.3 (VSS), IC4.14 (GND), IC4.15 (A2), J1.2, J2.1, J3.1, J4.1, J5.1, U1.6 (GND), U1.9 (GND), U1.14 (GND), U1.20 (GND), U1.25 (GND), U1.30 (GND), U1.34 (GND), U1.39 (GND), U2.3 (GND), U2.4 (GND), U4.2 (GND)
H1_RX: IC3.4 (S1), J2.3
H1_TX: IC4.4 (S1), J2.2
H2_RX: IC3.5 (S2), J3.3
H2_TX: IC4.5 (S2), J3.2
H3_RX: IC3.6 (S3), J4.3
H3_TX: IC4.6 (S3), J4.2
H4_RX: IC3.7 (S4), J5.3
H4_TX: IC4.7 (S4), J5.2
I2CSCL: IC1.5 (SCL), U1.5 (GPIO3/SCL1)
I2CSDA: IC1.4 (SDA), U1.3 (GPIO2/SDA1)
unnamed: IC1.3 (AIN), IC2.8 (D)
unnamed: U1.S1 (SHIELD), U1.S2 (SHIELD), U1.S3 (SHIELD), U1.S4 (SHIELD)
SB0: IC2.1 (A0), IC3.1 (A0), IC4.1 (A0), U1.16 (GPIO23/GPIO_GEN4)
SB1: IC2.16 (A1), IC3.16 (A1), IC4.16 (A1), U1.18 (GPIO24/GPIO_GEN5)
Switch_signal_1: J2.4, U1.7 (GPIO4/GPIO_GCKL)
Switch_signal_2: J3.4, U1.11 (GPIO17/GPIO_GEN0)
Switch_signal_3: J4.4, U1.13 (GPIO27/GPIO_GEN2)
Switch_signal_4: J5.4, U1.15 (GPIO22/GPIO_GEN3)
UART_RX: IC3.8 (D), U1.10 (RXD0/GPIO15)
UART_TX: IC4.8 (D), U1.8 (TXD0/GPIO14)

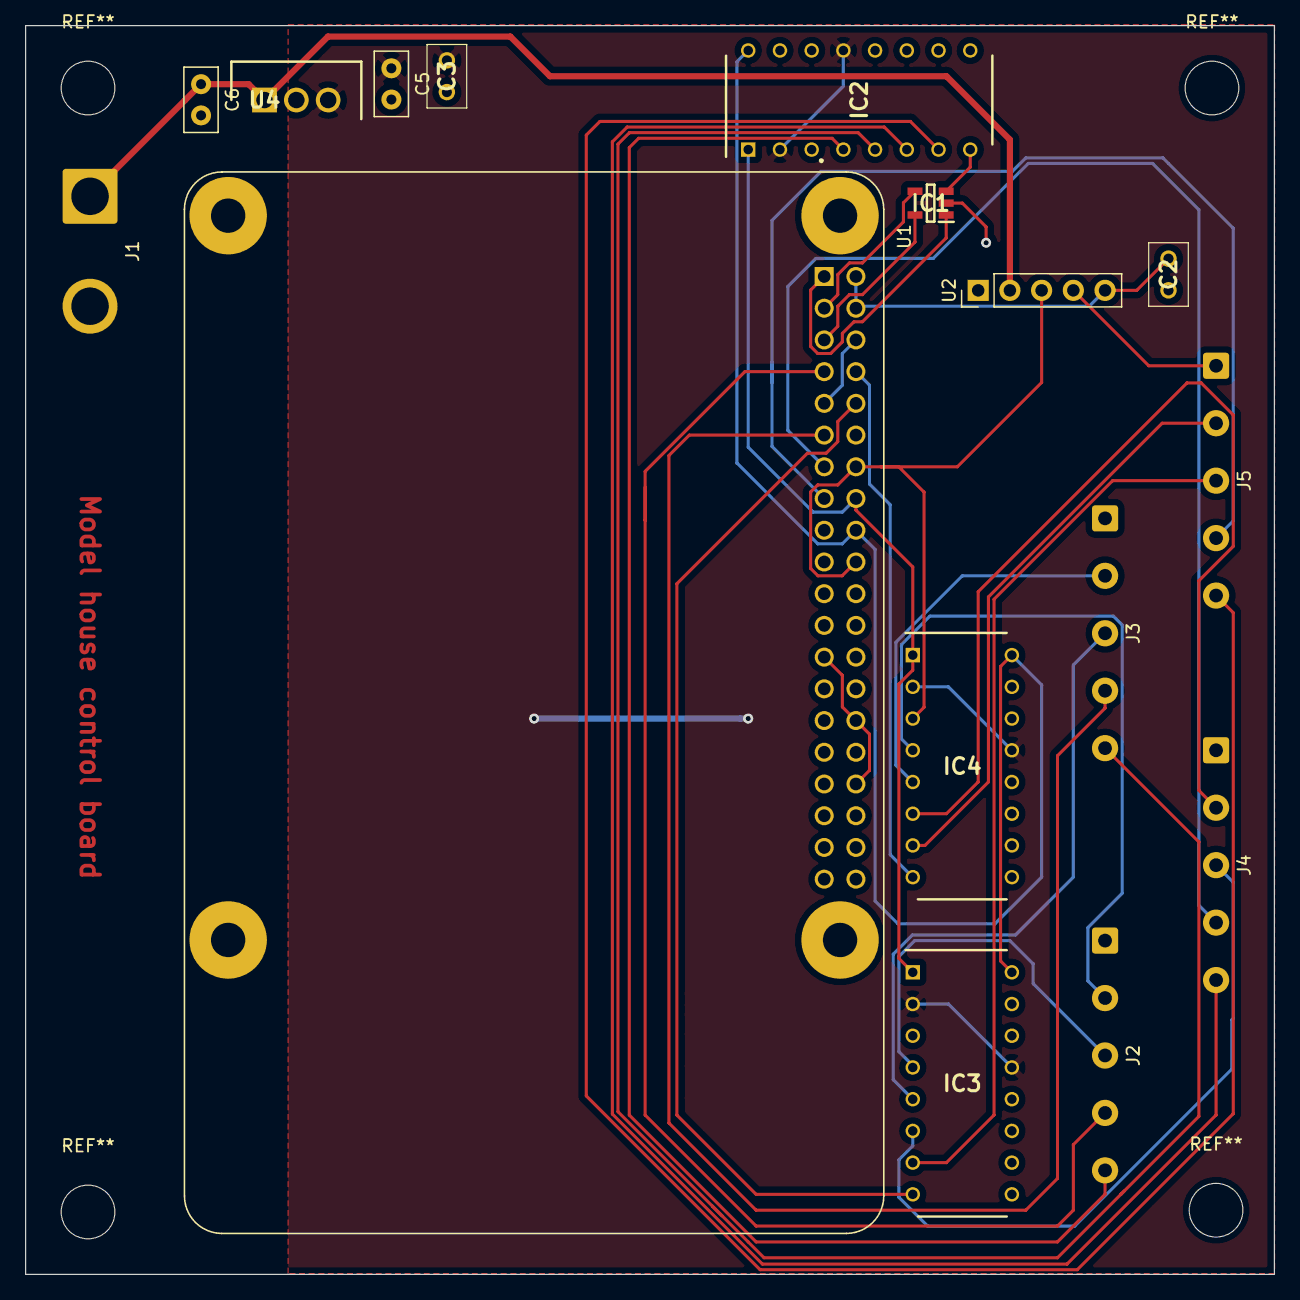
[picture p34: board HouseController.kicad_pcb from above]

Board: 2 copper layers, 100.0 x 100.0 mm, 16 parts (0 on the bottom side), 29 nets.
